Avvienash/Ultrasonic-Reverse-Sensor-with-Audible-and-Visual-Distance-Detector/Group86_LTSPICE_CarSensorasc.asc

C2: cap; 4.7µ
C3: cap; 0.1µ
C4: cap; 0.1µ
C5: cap; 4.7µ
D1: diode; 1N914
D2: diode; 1N914
Q1: npn
R1: res; 100
R2: res; 100
R3: res; 100
R4: res; 4.7k
R5: res; 100k
R6: res; 100
R7: res; 100
R8: res; 100
R9: res; 2500
R10: res; 2.2k
R11: res; 2500
U1: OP07
U2: OP07
U3: OP07
U5: OP07
V1: voltage; PULSE(1 3 0 0 0 0.25 .5 0)
V2: voltage; SINE(0 0.1 100 0 0 0 0)
V3: voltage; 5
V4: voltage; 5
V5: voltage; 10
Named nets: 0, Signal, Noise, Vcc, Vnn, V_input, V_filtered, V_neg_input, V_pos_input, VCO_output
.tran 1
Noisy Signal From Ultrasonic
Volatge Supply
First Order Active Low Pass Filter
Potentiometer as Voltage Divider
Single-Op-Amp Voltage-Controlled Oscillator (VCO)
Comparator
Transistor a Switch
Load (LED and Buzzer)
